UWCubeSat/radio-hw/README.md

# radio-hw

Work in progress OpenLST-based radio PCB with updated components.

## Pictures

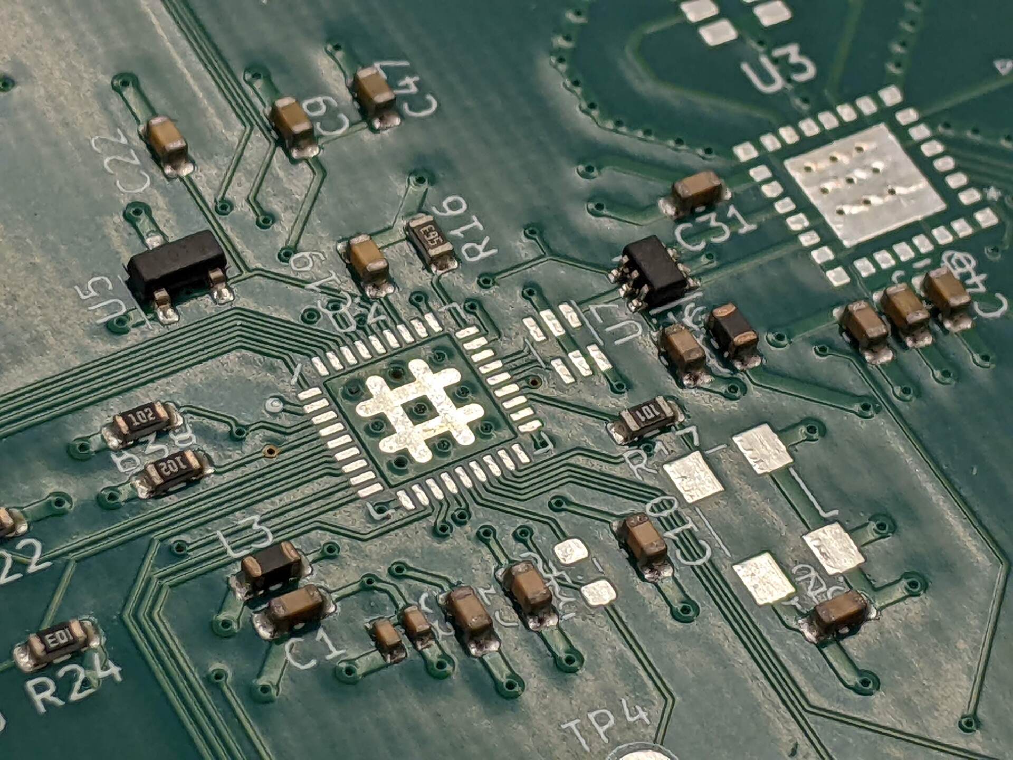
[picture p1: circuit.jpg]
Circuit board photograph


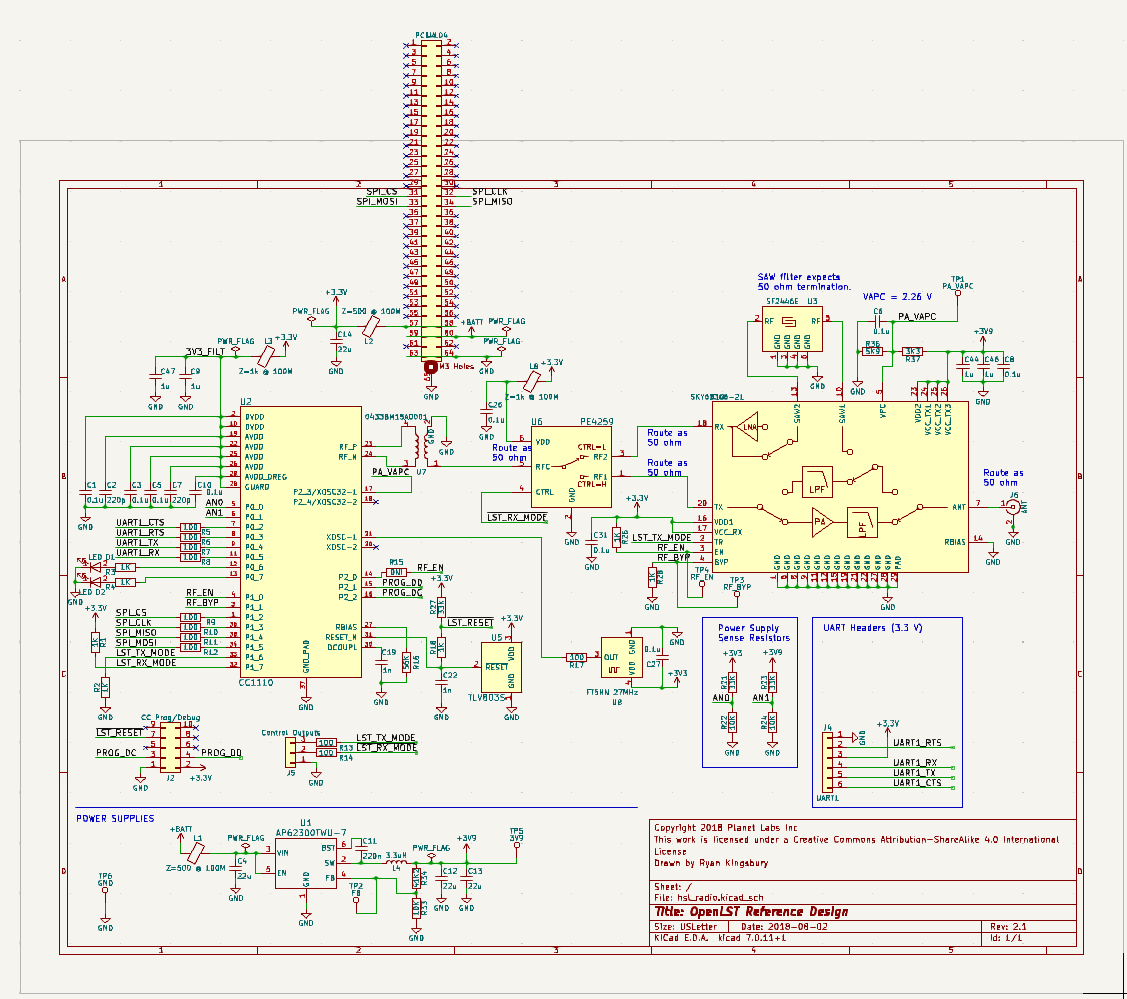
[picture p2: schematic_screenshot.png]
Schematic


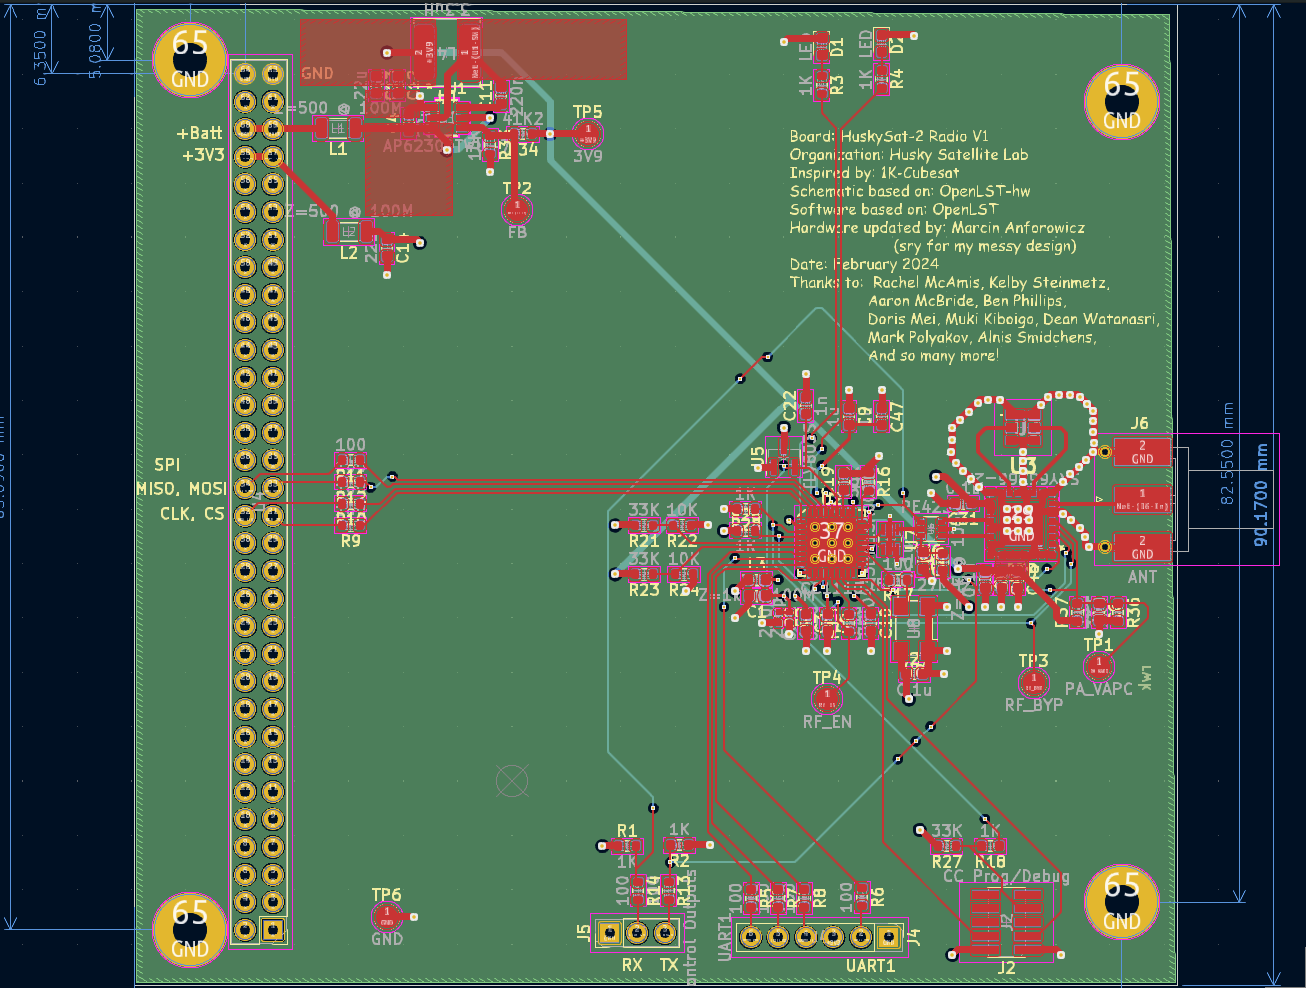
[picture p3: pcb_screenshot.png]
Circuit Board
