UWCubeSat/radio-hw/hsl_radio.kicad_pcb

## KiCad design hsl_radio.kicad_pcb (2024-02-27)

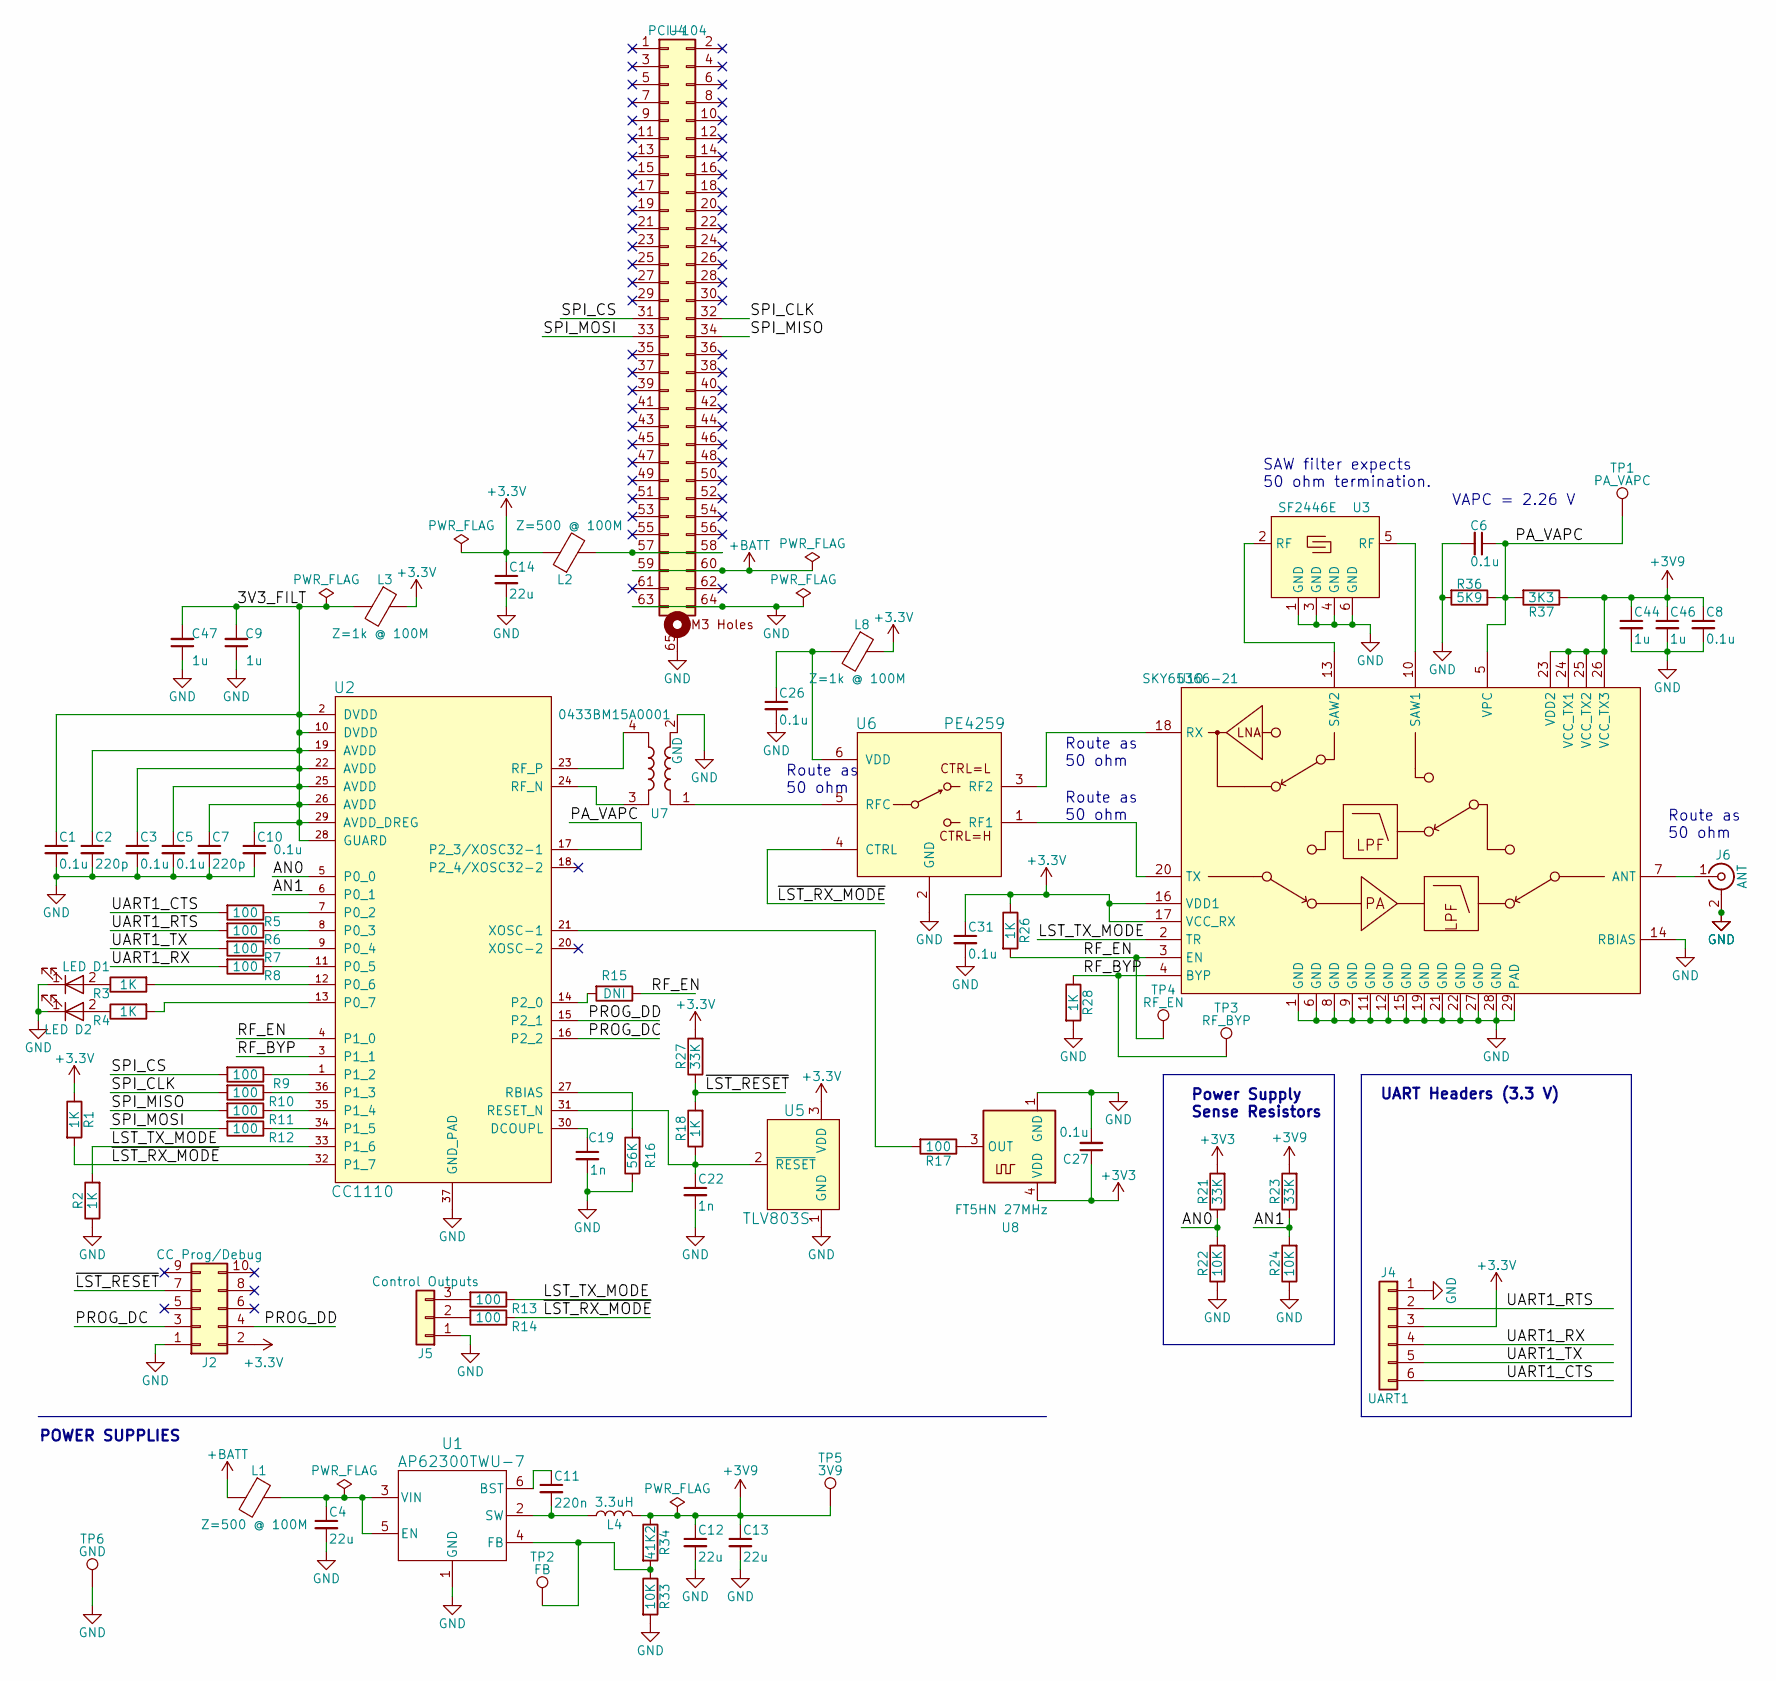
[picture p4: schematic hsl_radio.kicad_sch, OpenLST Reference Design]

Parts:
C1, C3, C5, C6, C8, C10, C26, C27, C31: 0.1u; C_0603_1608Metric; ManufPN 0603YC104K4T4A
C2, C7: 220p; C_0402_1005Metric; ManufPN C0402C221J2GACAUTO
C4, C12, C13, C14: 22u; C_0603_1608Metric
C9, C44, C46, C47: 1u; C_0603_1608Metric; ManufPN CL10B105MO8NNWC
C11: 220n; C_0603_1608Metric
C19, C22: 1n; C_0603_1608Metric; ManufPN GCM188R71E102KA37D
D1: LED; LED_0603_1608Metric; ManufPN 150060VS75000
D2: LED; LED_0603_1608Metric; ManufPN 150060SS75000
J2: CC Prog/Debug; PinHeader_2x05_P1.27mm_Vertical_SMD; ManufPN FTSH-105-01-L-DV-K-P
J4: UART1; PinHeader_1x06_P2.54mm_Vertical; ManufPN 61300611121
J5: Control Outputs; PinHeader_1x03_P2.54mm_Vertical
J6: ANT; SMA_Molex_73251-1153_EdgeMount_Horizontal; ManufPN 732511150
L1, L2: Z=500 @ 100M; L_1206_3216Metric; ManufPN MI1206L501R-10
L3, L8: Z=1k @ 100M; L_0603_1608Metric; ManufPN 74279266
L4: 3.3uH; L_TDK_VLS6045EX_VLS6045AF
R1, R2, R3, R4, R18, R26, R28: 1K; R_0603_1608Metric; ManufPN RC0603JR-071KL
R5, R6, R7, R8, R9, R10, R11, R12, R13, R14, R17: 100; R_0603_1608Metric; ManufPN AC0603FR-07100RL
R15: DNI; R_0603_1608Metric
R16: 56K; R_0603_1608Metric; ManufPN RMCF0603FT56K0
R21, R23, R27: 33K; R_0603_1608Metric; ManufPN AC0603FR-0733KL
R22, R24: 10K; R_0603_1608Metric; ManufPN RC0603JR-0710KL
R33: 10K; R_0603_1608Metric
R34: 41K2; R_0603_1608Metric
R36: 5K9; R_0603_1608Metric; ManufPN RMCF0603FT5K60
R37: 3K3; R_0603_1608Metric; ManufPN RMCF0603FT3K30
TP1: PA_VAPC; TestPoint_Pad_D2.0mm
TP2: FB; TestPoint_Pad_D2.0mm
TP3: RF_BYP; TestPoint_Pad_D2.0mm
TP4: RF_EN; TestPoint_Pad_D2.0mm
TP5: 3V9; TestPoint_Pad_D2.0mm
TP6: GND; TestPoint_Pad_D2.0mm
U1: AP62300TWU-7; TSOT26-WU_DIO
U2: CC1110; TI_CC_QFN36; ManufPN CC1110F32RHHR
U3: SF2446E
U4: PCI-104; PCI104
U5: TLV803S; SOT-23; ManufPN TLV803SDBZR
U6: PE4259; SOT-363_SC-70-6; ManufPN 4259-63
U7: 0433BM15A0001; Balun_Johanson_0896BM15A0001
U8: FT5HN 27MHz; Oscillator_SMD_Fox_FT5H_5.0x3.2mm
U10: SKY65366-21

Connections:
+3V9: C8.1, C12.1, C13.1, C44.1, C46.1, L4.2, R23.2, R34.1, R37.1, TP5.1, U10.23 (VDD2), U10.24 (VCC_TX1), U10.25 (VCC_TX2), U10.26 (VCC_TX3)
+BATT: L1.2, U4.59, U4.60
/3V3_FILT: C1.1, C2.1, C3.1, C5.1, C7.1, C9.2, C10.1, C47.2, L3.2, U2.2 (DVDD), U2.10 (DVDD), U2.19 (AVDD), U2.22 (AVDD), U2.25 (AVDD), U2.26 (AVDD), U2.28 (GUARD), U2.29 (AVDD_DREG)
/AN0: R21.1, R22.2, U2.5 (P0_0)
/AN1: R23.1, R24.2, U2.6 (P0_1)
/LST_TX_MODE: R2.2, R13.1, U2.33 (P1_6), U10.2 (TR)
/PA_VAPC: C6.1, R36.1, R37.2, TP1.1, U2.17 (P2_3/XOSC32-1), U10.5 (VPC)
/PROG_DC: J2.3, U2.16 (P2_2)
/PROG_DD: J2.4, U2.15 (P2_1)
/RF_BYP: R28.1, TP3.1, U2.3 (P1_1), U10.4 (BYP)
/RF_EN: R15.1, R26.2, TP4.1, U2.4 (P1_0), U10.3 (EN)
/SPI_CLK: R10.2, U4.32
/SPI_CS: R9.2, U4.31
/SPI_MISO: R11.2, U4.34
/SPI_MOSI: R12.2, U4.33
/UART1_CTS: J4.6, R5.2
/UART1_RTS: J4.2, R6.2
/UART1_RX: J4.4, R8.2
/UART1_TX: J4.5, R7.2
/~LST_RESET: J2.7, R18.2, R27.1
/~LST_RX_MODE: R1.2, R14.1, U2.32 (P1_7), U6.4 (CTRL)
GND: C1.2, C2.2, C3.2, C4.2, C5.2, C6.2, C7.2, C8.2, C9.1, C10.2, C12.2, C13.2, C14.2, C19.2, C22.2, C26.2, C27.2, C31.2, C44.2, C46.2, C47.1, D1.1 (K), D2.1 (K), J2.1, J4.1, J5.1, J6.2 (Ext), R2.1, R16.1, R22.1, R24.1, R28.2, R33.2, R36.2, TP6.1, U1.1 (GND), U2.37 (GND_PAD), U3.1 (GND), U3.3 (GND), U3.4 (GND), U3.6 (GND), U4.63, U4.64, U4.65 (Holes), U5.1 (GND), U6.2 (GND), U7.2 (GND), U7.5 (GND), U7.6 (GND), U8.1 (GND), U8.2 (GND), U10.1 (GND), U10.6 (GND), U10.8 (GND), U10.9 (GND), U10.11 (GND), U10.12 (GND), U10.14 (RBIAS), U10.15 (GND), U10.19 (GND), U10.21 (GND), U10.22 (GND), U10.27 (GND), U10.28 (GND), U10.29 (PAD)
unnamed: D1.2 (A), R3.1
unnamed: D2.2 (A), R4.1
unnamed: J5.2, R14.2
unnamed: J5.3, R13.2
unnamed: J6.1 (In), U10.7 (ANT)
unnamed: C11.1, U1.6 (BST)
unnamed: C4.1, L1.1, U1.3 (VIN), U1.5 (EN)
unnamed: R33.1, R34.2, TP2.1, U1.4 (FB)
unnamed: C11.2, L4.1, U1.2 (SW)
unnamed: C19.1, U2.30 (DCOUPL)
unnamed: R5.1, U2.7 (P0_2)
unnamed: R6.1, U2.8 (P0_3)
unnamed: R7.1, U2.9 (P0_4)
unnamed: R8.1, U2.11 (P0_5)
unnamed: R3.2, U2.12 (P0_6)
unnamed: R4.2, U2.13 (P0_7)
unnamed: R9.1, U2.1 (P1_2)
unnamed: R10.1, U2.36 (P1_3)
unnamed: R11.1, U2.35 (P1_4)
unnamed: R12.1, U2.34 (P1_5)
unnamed: R15.2, U2.14 (P2_0)
unnamed: R16.2, U2.27 (RBIAS)
unnamed: C22.1, R18.1, U2.31 (RESET_N), U5.2 (~RESET)
unnamed: U2.24 (RF_N), U7.3
unnamed: U2.23 (RF_P), U7.4
unnamed: R17.2, U2.21 (XOSC-1)
unnamed: L2.2, U4.57, U4.58
unnamed: U6.5 (RFC), U7.1
unnamed: C26.1, L8.2, U6.6 (VDD)
unnamed: R17.1, U8.3 (OUT)
unnamed: U6.3 (RF2), U10.18 (RX)
unnamed: U3.5 (RF), U10.10 (SAW1)
unnamed: U3.2 (RF), U10.13 (SAW2)
unnamed: U6.1 (RF1), U10.20 (TX)

Notes on the sheet:
UART Headers (3.3 V)
Route as 50 ohm
Power Supply Sense Resistors
POWER SUPPLIES
VAPC = 2.26 V
SAW filter expects 50 ohm termination.

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
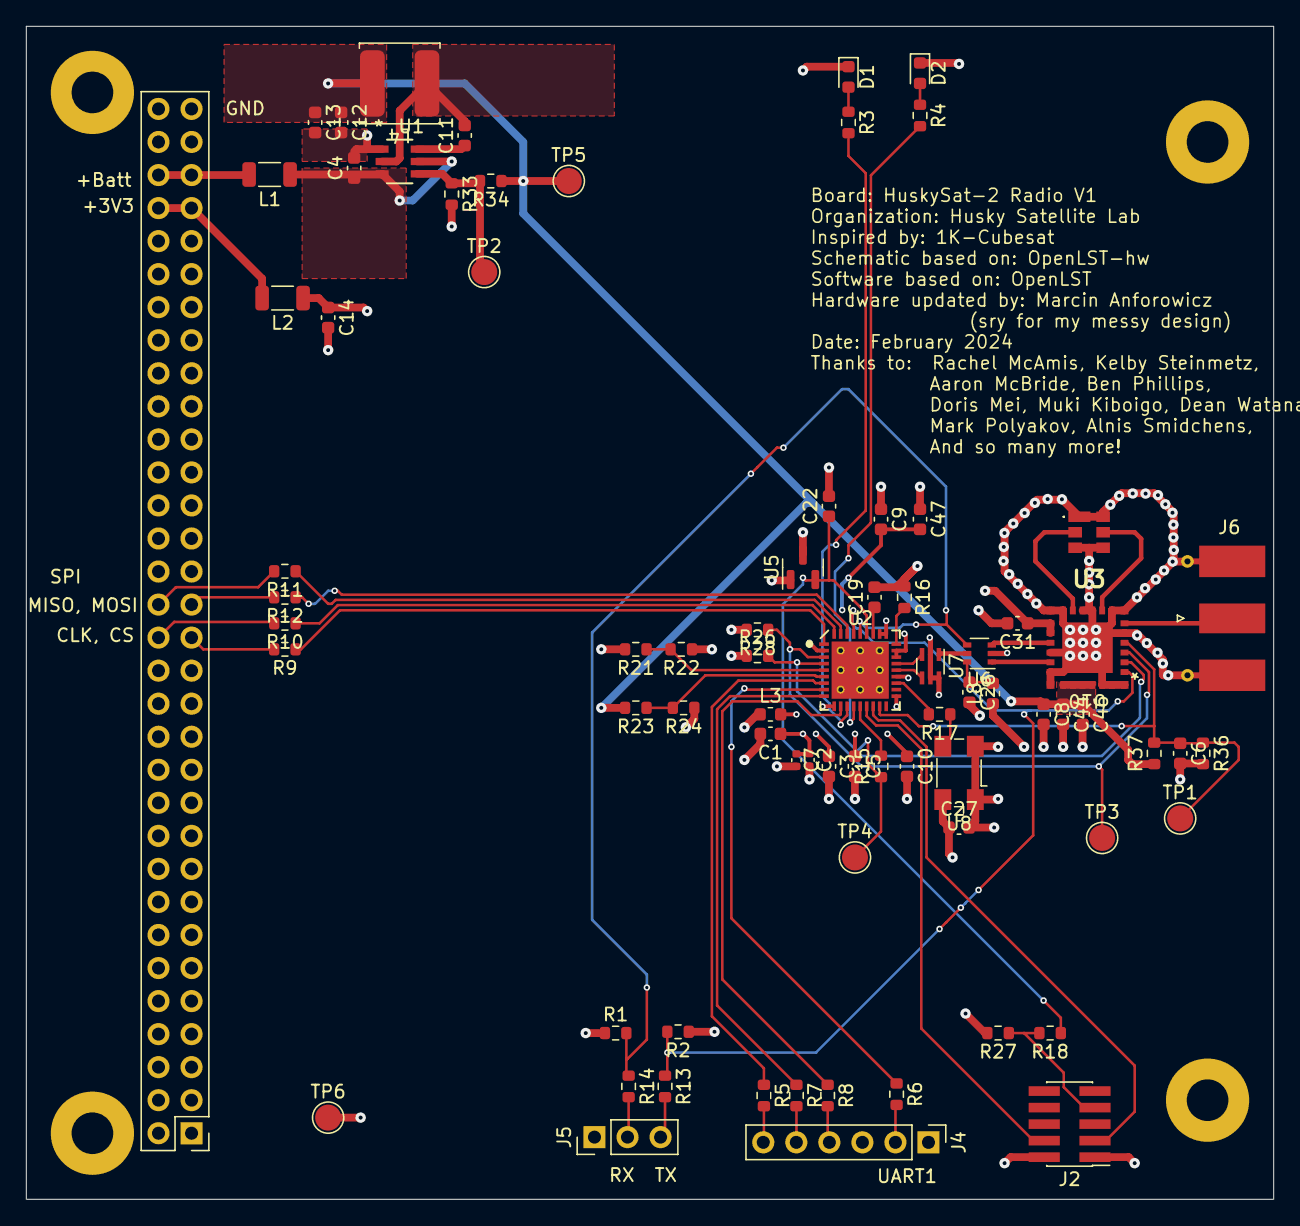
[picture p5: board hsl_radio.kicad_pcb from above]

Board: 4 copper layers, 95.9 x 90.2 mm, 77 parts (0 on the bottom side), 57 nets.
