UWCubeSat/radio-hw/(commit log)

2024-02-19 Preparing for JLCPCB
    [hsl_radio-B.Cu.gbl, hsl_radio-B.Mask.gbs, hsl_radio-B.Paste.gbp, hsl_radio-B.SilkS.gbo, hsl_radio-B_Cu.gbl, hsl_radio-B_Mask.gbs, hsl_radio-B_Paste.gbp, hsl_radio-B_Silkscreen.gbo]
2024-02-23 Added test points
    [hsl_radio-B_Cu.gbl, hsl_radio-B_Mask.gbs, hsl_radio-B_Paste.gbp, hsl_radio-B_Silkscreen.gbo, hsl_radio-Edge_Cuts.gm1, hsl_radio-F_Cu.gtl, hsl_radio-F_Mask.gts, hsl_radio-F_Paste.gtp]
2024-02-23 Finalizing for JLCPCB
    [hsl_radio-B_Cu.gbl, hsl_radio-B_Mask.gbs, hsl_radio-B_Paste.gbp, hsl_radio-B_Silkscreen.gbo, hsl_radio-Edge_Cuts.gm1, hsl_radio-F_Cu.gtl, hsl_radio-F_Mask.gts, hsl_radio-F_Paste.gtp]
2024-02-27 Finalized things
    [hsl_radio-B_Cu.gbl, hsl_radio-B_Mask.gbs, hsl_radio-B_Paste.gbp, hsl_radio-B_Silkscreen.gbo, hsl_radio-Edge_Cuts.gm1, hsl_radio-F_Cu.gtl, hsl_radio-F_Mask.gts, hsl_radio-F_Paste.gtp]
