UWCubeSat/radio-hw/(notices)

Notices in the files:
hsl_radio.sch:
This work is licensed under a Creative Commons Attribution-ShareAlike 4.0 International
Copyright 2018 Planet Labs Inc
